rolandkohn/ATinyCrawl/hardware/enclosure/ATinyCrawl_BoxBottom.stl

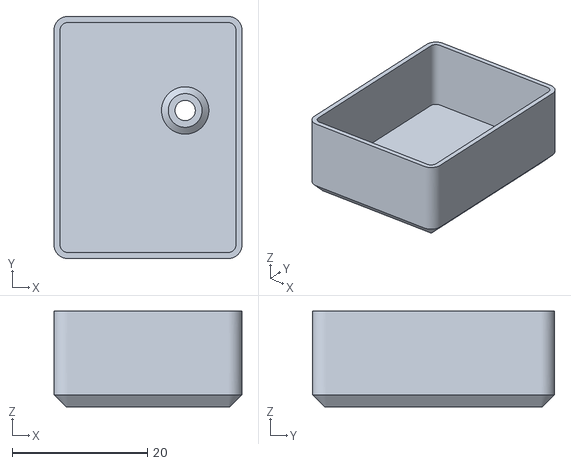
[picture p3: CAD file, 2026-10-26]
hardware/enclosure/ATinyCrawl_BoxBottom.stl
27.8 x 35.8 x 14.2
