rolandkohn/ATinyCrawl/hardware/enclosure/ATinyCrawl_BoxTop.stl

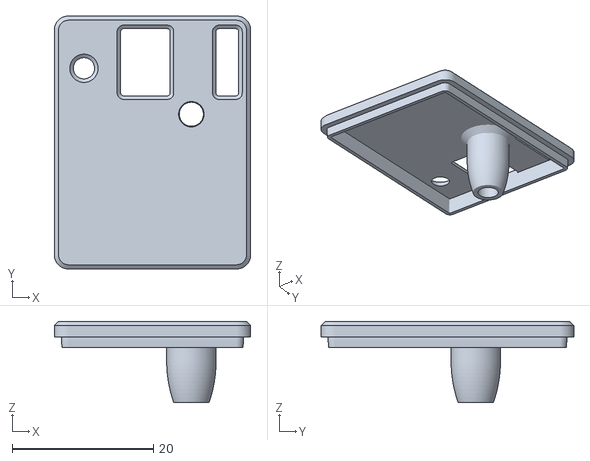
[picture p4: CAD file, 2026-10-26]
hardware/enclosure/ATinyCrawl_BoxTop.stl
27.8 x 35.8 x 11.5
