rolandkohn/ATinyCrawl/(commit log)

2026-10-26 Add perfboard layout PDF and board images
2026-10-26 Add 3D-printable enclosure (M3 x 16)
    [ATinyCrawl_BoxBottom.stl, ATinyCrawl_BoxTop.stl]
2026-10-26 README: AUX push buttons work too
2026-10-26 Docs: AUX push buttons work too
